soldernerd/LubricatonController_Hardware/CentralLubrication_RevA.brd

## EAGLE design CentralLubrication_RevA.brd (2020-12-08)

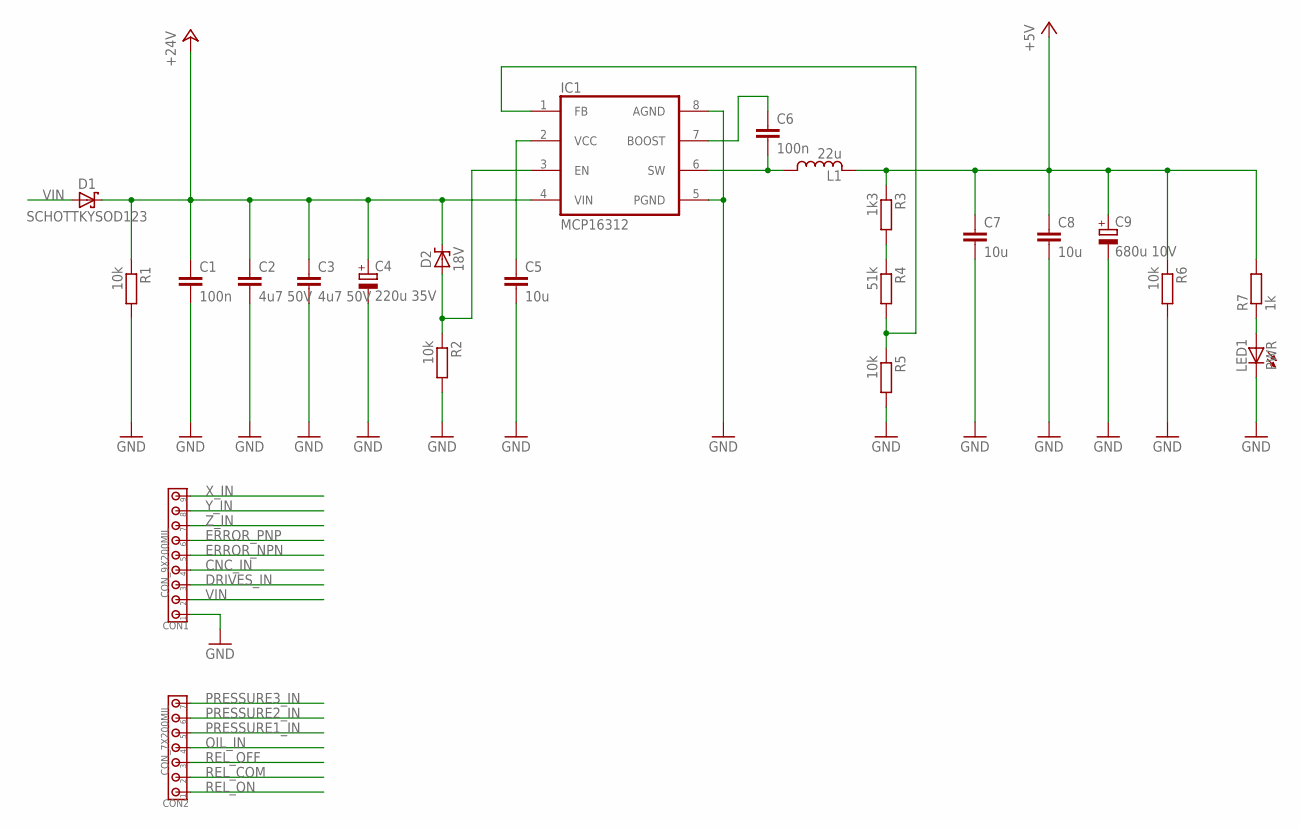
[picture p1: schematic CentralLubrication_RevA.sch, sheet 1]

Parts:
C1, C6: 100n; C0805
C2, C3: 4u7 50V; C1206
C4: 220u 35V; 8MM
C5, C7, C8: 10u; C0805
C9: 680u 10V; 8MM
CON1: CON_9X200MIL; 200MIL_9X
CON2: CON_7X200MIL; 200MIL_7X
D1: SCHOTTKYSOD123; SOD123
D2: 18V; SOD323
IC1: MCP16312; MSOP8
L1: 22u; LPS4018
LED1: PWR; LED0805_NOBOARDER
R1, R2, R5, R6: 10k; R0805
R3: 1k3; R0805
R4: 51k; R0805
R7: 1k; R0805

Connections:
+5V: C7.1, C8.1, C9.+, L1.2, R3.1, R6.1, R7.2; also elsewhere on the board
+24V: C1.1, C2.1, C3.1, C4.+, D1.C, D2.C, IC1.4 (VIN), R1.1; also elsewhere on the board
BOOST: C6.1, IC1.7 (BOOST)
CNC_IN: CON1.4; also elsewhere on the board
DRIVES_IN: CON1.3; also elsewhere on the board
ERROR_NPN: CON1.5; also elsewhere on the board
ERROR_PNP: CON1.6; also elsewhere on the board
GND: C1.2, C2.2, C3.2, C4.-, C5.2, C7.2, C8.2, C9.-, CON1.1, IC1.5 (PGND), IC1.8 (AGND), LED1.C, R1.2, R2.2, R5.2, R6.2; also elsewhere on the board
unnamed: IC1.1 (FB), R4.2, R5.1
unnamed: R3.2, R4.1
unnamed: C5.1, IC1.2 (VCC)
unnamed: D2.A, IC1.3 (EN), R2.1
unnamed: LED1.A, R7.1
OIL_IN: CON2.4; also elsewhere on the board
PRESSURE1_IN: CON2.5; also elsewhere on the board
PRESSURE2_IN: CON2.6; also elsewhere on the board
PRESSURE3_IN: CON2.7; also elsewhere on the board
REL_COM: CON2.2; also elsewhere on the board
REL_OFF: CON2.3; also elsewhere on the board
REL_ON: CON2.1; also elsewhere on the board
SWITCH1: C6.2, IC1.6 (SW), L1.1
VIN: CON1.2, D1.A
X_IN: CON1.9; also elsewhere on the board
Y_IN: CON1.8; also elsewhere on the board
Z_IN: CON1.7; also elsewhere on the board

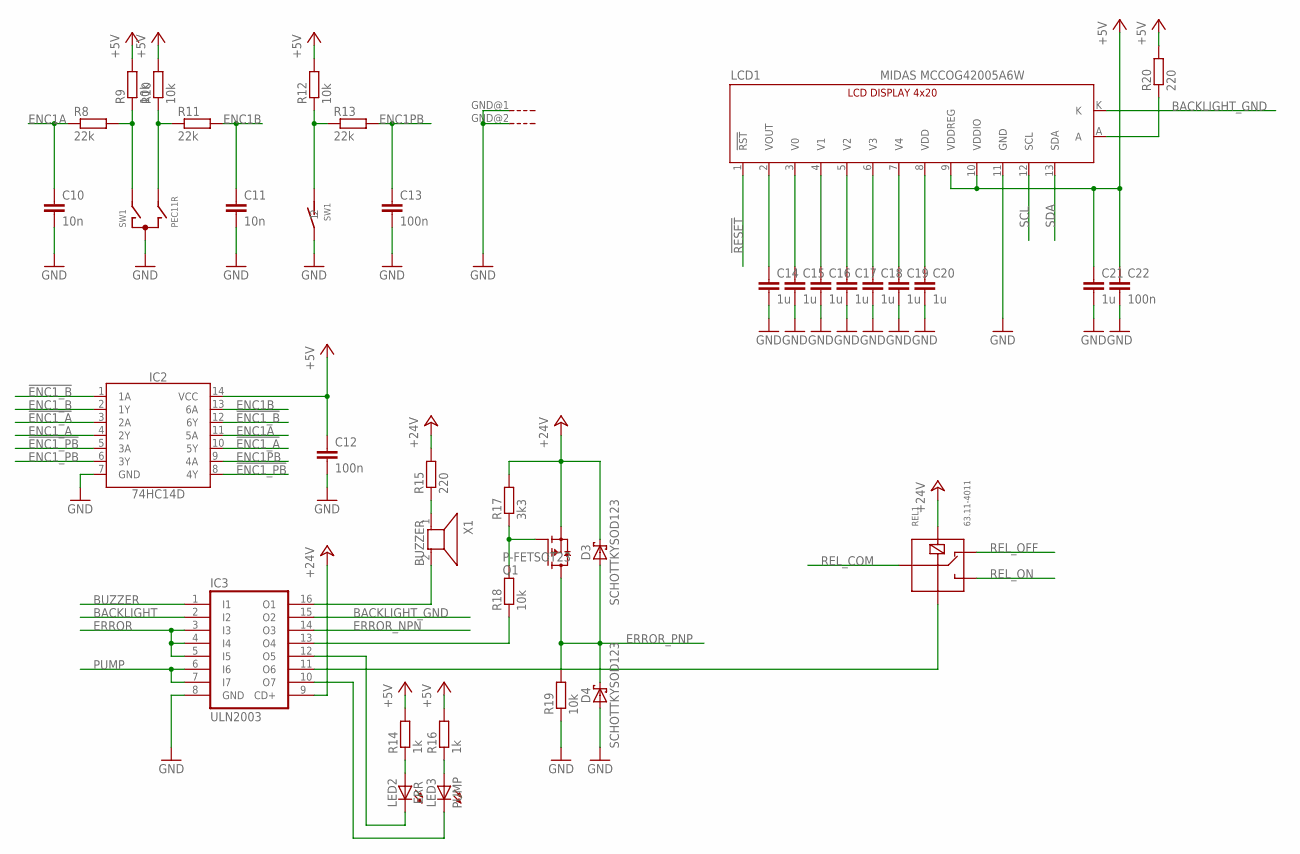
[picture p2: schematic CentralLubrication_RevA.sch, sheet 2]

Parts:
C10, C11: 10n; C0805
C12, C13, C22: 100n; C0805
C14, C15, C16, C17, C18, C19, C20, C21: 1u; C0805
D3, D4: SCHOTTKYSOD123; SOD123
IC2: 74HC14D; SO14
IC3: ULN2003; SO16
LCD1: MIDAS MCCOG42005A6W; LCD_4X20_I2C
LED2: ERR; LED0805_NOBOARDER
LED3: PUMP; LED0805_NOBOARDER
Q1: P-FETSOT23; SOT23
R8, R11, R13: 22k; R0805
R9, R10, R12, R18, R19: 10k; R0805
R14, R16: 1k; R0805
R15, R20: 220; R0805
R17: 3k3; R0805
REL1: 63.11-4011; G5LE
SW1: PEC11R; ENCODER_BOURNS
X1: BUZZER; BUZZER_14MM

Connections:
!ENC1_A!: IC2.3 (2A), IC2.10 (5Y)
!ENC1_B!: IC2.1 (1A), IC2.12 (6Y)
!ENC1_PB!: IC2.5 (3A), IC2.8 (4Y)
!RESET!: LCD1.1 (!RST!); also elsewhere on the board
+5V: C12.1, C21.1, C22.1, IC2.14 (VCC), LCD1.9 (VDDREG), LCD1.10 (VDDIO), R9.2, R10.2, R12.2, R14.2, R16.2, R20.2; also elsewhere on the board
+24V: D3.C, IC3.9 (CD+), Q1.2 (S), R15.2, R17.2, REL1.2; also elsewhere on the board
BACKLIGHT: IC3.2 (I2); also elsewhere on the board
BACKLIGHT_GND: IC3.15 (O2), LCD1.K
BUZZER: IC3.1 (I1); also elsewhere on the board
BUZZER_GND: IC3.16 (O1), X1.2
ENC1A: C10.1, IC2.11 (5A), R8.1
ENC1B: C11.1, IC2.13 (6A), R11.2
ENC1PB: C13.1, IC2.9 (4A), R13.2
ENC1_A: IC2.4 (2Y); also elsewhere on the board
ENC1_B: IC2.2 (1Y); also elsewhere on the board
ENC1_PB: IC2.6 (3Y); also elsewhere on the board
ERROR: IC3.3 (I3), IC3.4 (I4), IC3.5 (I5); also elsewhere on the board
ERROR_NPN: IC3.14 (O3); also elsewhere on the board
ERROR_PNP: D3.A, D4.C, Q1.3 (D), R19.2; also elsewhere on the board
GND: C10.2, C11.2, C12.2, C13.2, C14.2, C15.2, C16.2, C17.2, C18.2, C19.2, C20.2, C21.2, C22.2, D4.A, IC2.7 (GND), IC3.8 (GND), LCD1.11 (GND), R19.1, SW1.2, SW1.C, SW1.GND@1 (G), SW1.GND@2 (G); also elsewhere on the board
unnamed: C20.1, LCD1.8 (VDD)
unnamed: R15.1, X1.1
unnamed: R10.1, R11.1, SW1.B
unnamed: R8.2, R9.1, SW1.A
unnamed: LCD1.A, R20.1
unnamed: IC3.11 (O6), REL1.1
unnamed: Q1.1 (G), R17.1, R18.2
unnamed: R12.1, R13.1, SW1.1
unnamed: IC3.13 (O4), R18.1
unnamed: C14.1, LCD1.2 (VOUT)
unnamed: C15.1, LCD1.3 (V0)
unnamed: C19.1, LCD1.7 (V4)
unnamed: C18.1, LCD1.6 (V3)
unnamed: C17.1, LCD1.5 (V2)
unnamed: C16.1, LCD1.4 (V1)
unnamed: IC3.10 (O7), LED3.C
unnamed: LED2.A, R14.1
unnamed: LED3.A, R16.1
unnamed: IC3.12 (O5), LED2.C
PUMP: IC3.6 (I6), IC3.7 (I7); also elsewhere on the board
REL_COM: REL1.COM; also elsewhere on the board
REL_OFF: REL1.O; also elsewhere on the board
REL_ON: REL1.C; also elsewhere on the board
SCL: LCD1.12 (SCL); also elsewhere on the board
SDA: LCD1.13 (SDA); also elsewhere on the board

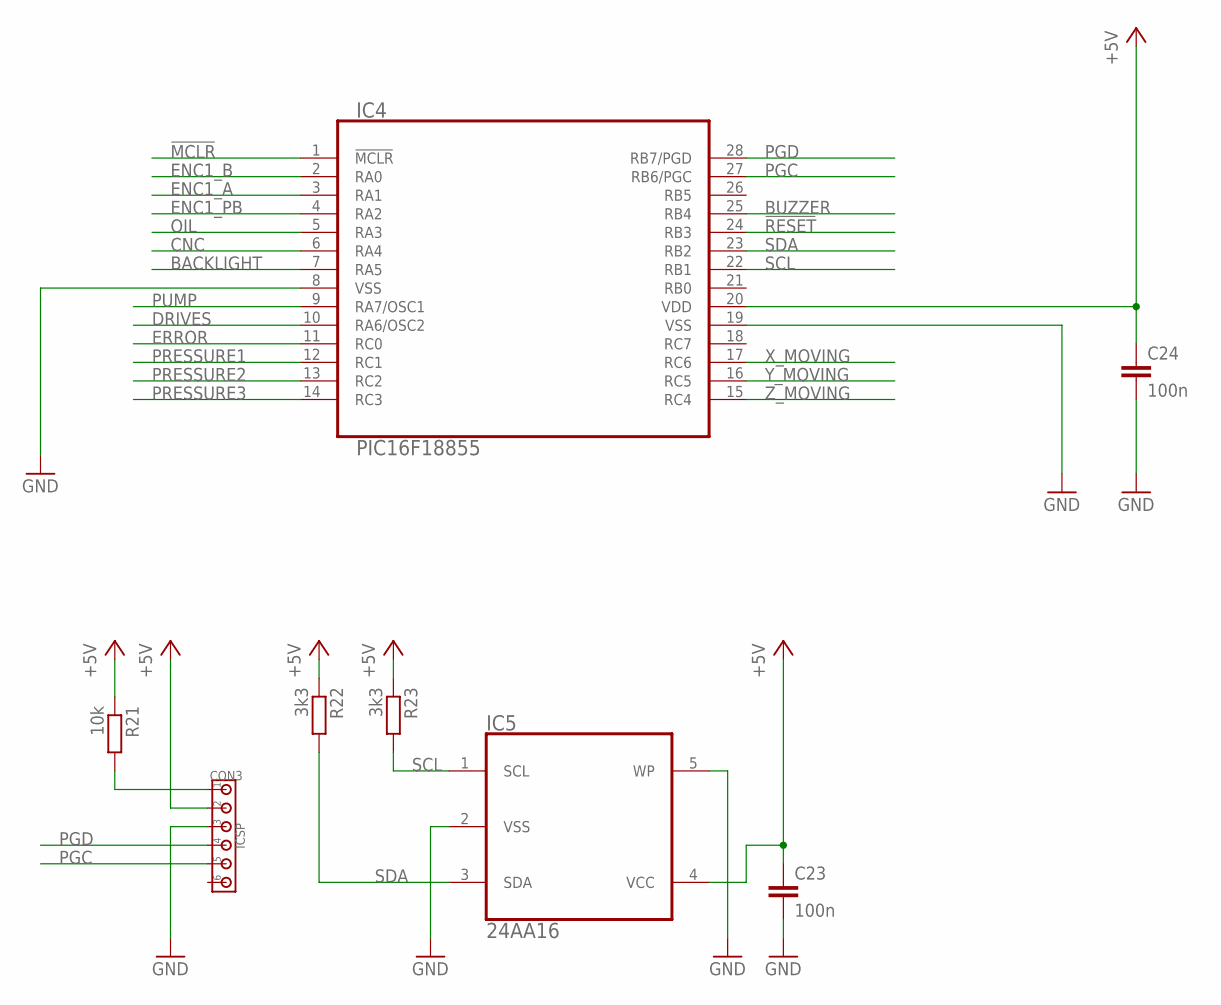
[picture p3: schematic CentralLubrication_RevA.sch, sheet 3]

Parts:
C23, C24: 100n; C0805
CON3: ICSP; 100MIL_6X
IC4: PIC16F18855; SO28W
IC5: 24AA16; SOT-23-5
R21: 10k; R0805
R22, R23: 3k3; R0805

Connections:
!MCLR!: CON3.1, IC4.1 (!MCLR!), R21.2
!RESET!: IC4.24 (RB3); also elsewhere on the board
+5V: C23.1, C24.1, CON3.2, IC4.20 (VDD), IC5.4 (VCC), R21.1, R22.1, R23.1; also elsewhere on the board
BACKLIGHT: IC4.7 (RA5); also elsewhere on the board
BUZZER: IC4.25 (RB4); also elsewhere on the board
CNC: IC4.6 (RA4); also elsewhere on the board
DRIVES: IC4.10 (RA6/OSC2); also elsewhere on the board
ENC1_A: IC4.3 (RA1); also elsewhere on the board
ENC1_B: IC4.2 (RA0); also elsewhere on the board
ENC1_PB: IC4.4 (RA2); also elsewhere on the board
ERROR: IC4.11 (RC0); also elsewhere on the board
GND: C23.2, C24.2, CON3.3, IC4.8 (VSS), IC4.19 (VSS), IC5.2 (VSS), IC5.5 (WP); also elsewhere on the board
OIL: IC4.5 (RA3); also elsewhere on the board
PGC: CON3.5, IC4.27 (RB6/PGC)
PGD: CON3.4, IC4.28 (RB7/PGD)
PRESSURE1: IC4.12 (RC1); also elsewhere on the board
PRESSURE2: IC4.13 (RC2); also elsewhere on the board
PRESSURE3: IC4.14 (RC3); also elsewhere on the board
PUMP: IC4.9 (RA7/OSC1); also elsewhere on the board
SCL: IC4.22 (RB1), IC5.1 (SCL), R23.2; also elsewhere on the board
SDA: IC4.23 (RB2), IC5.3 (SDA), R22.2; also elsewhere on the board
X_MOVING: IC4.17 (RC6); also elsewhere on the board
Y_MOVING: IC4.16 (RC5); also elsewhere on the board
Z_MOVING: IC4.15 (RC4); also elsewhere on the board

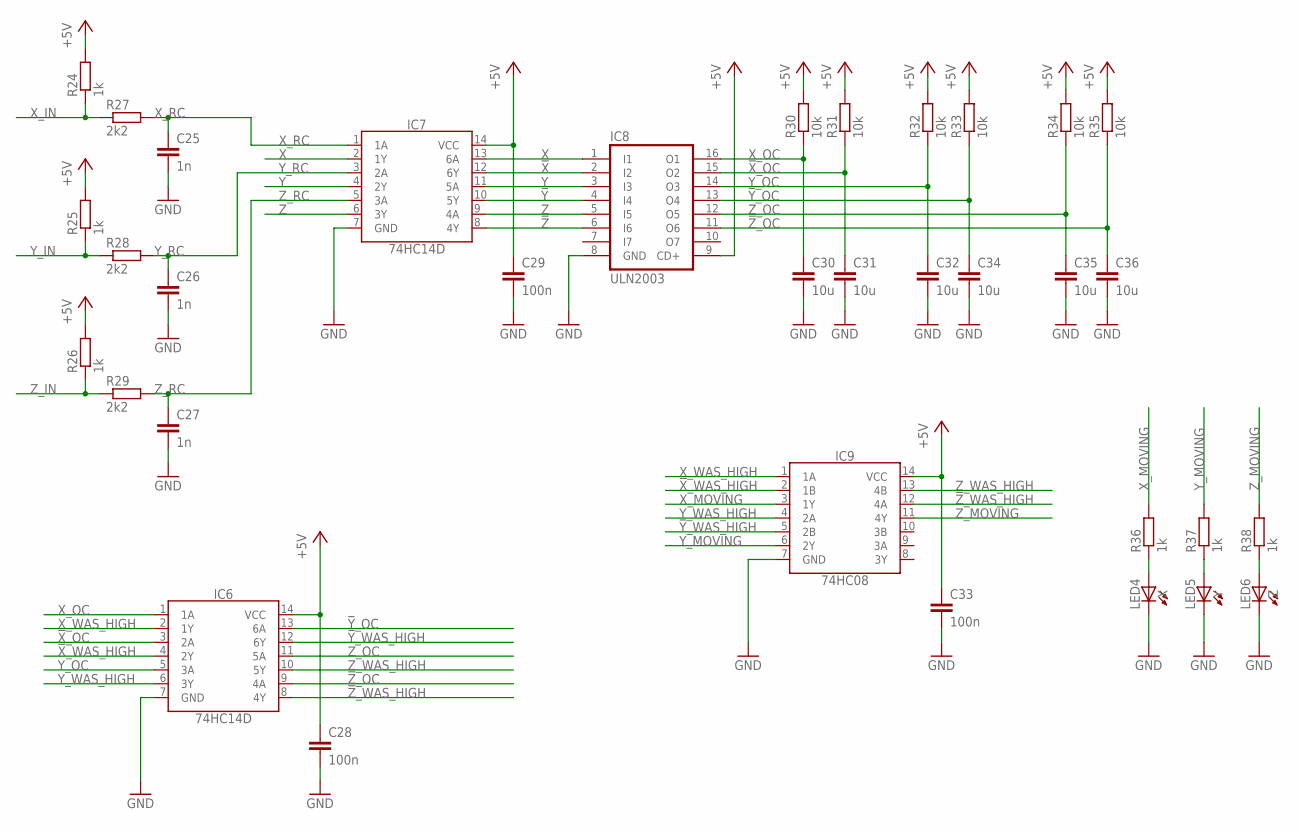
[picture p4: schematic CentralLubrication_RevA.sch, sheet 4]

Parts:
C25, C26, C27: 1n; C0805
C28, C29, C33: 100n; C0805
C30, C31, C32, C34, C35, C36: 10u; C0805
IC6, IC7: 74HC14D; SO14
IC8: ULN2003; SO16
IC9: 74HC08; SO14
LED4: X; LED0805_NOBOARDER
LED5: Y; LED0805_NOBOARDER
LED6: Z; LED0805_NOBOARDER
R24, R25, R26, R36, R37, R38: 1k; R0805
R27, R28, R29: 2k2; R0805
R30, R31, R32, R33, R34, R35: 10k; R0805

Connections:
!X!: IC7.12 (6Y), IC8.2 (I2)
!X!_OC: C31.1, IC6.3 (2A), IC8.15 (O2), R31.1
!X!_WAS_HIGH: IC6.4 (2Y), IC9.2 (1B)
!Y!: IC7.10 (5Y), IC8.4 (I4)
!Y!_OC: C34.1, IC6.13 (6A), IC8.13 (O4), R33.1
!Y!_WAS_HIGH: IC6.12 (6Y), IC9.5 (2B)
!Z!: IC7.8 (4Y), IC8.6 (I6)
!Z!_OC: C36.1, IC6.9 (4A), IC8.11 (O6), R35.1
!Z!_WAS_HIGH: IC6.8 (4Y), IC9.12 (4A)
+5V: C28.1, C29.1, C33.1, IC6.14 (VCC), IC7.14 (VCC), IC8.9 (CD+), IC9.14 (VCC), R24.2, R25.2, R26.2, R30.2, R31.2, R32.2, R33.2, R34.2, R35.2; also elsewhere on the board
GND: C25.2, C26.2, C27.2, C28.2, C29.2, C30.2, C31.2, C32.2, C33.2, C34.2, C35.2, C36.2, IC6.7 (GND), IC7.7 (GND), IC8.8 (GND), IC9.7 (GND), LED4.C, LED5.C, LED6.C; also elsewhere on the board
unnamed: LED4.A, R36.1
unnamed: LED5.A, R37.1
unnamed: LED6.A, R38.1
X: IC7.2 (1Y), IC7.13 (6A), IC8.1 (I1)
X_IN: R24.1, R27.1; also elsewhere on the board
X_MOVING: IC9.3 (1Y), R36.2; also elsewhere on the board
X_OC: C30.1, IC6.1 (1A), IC8.16 (O1), R30.1
X_RC: C25.1, IC7.1 (1A), R27.2
X_WAS_HIGH: IC6.2 (1Y), IC9.1 (1A)
Y: IC7.4 (2Y), IC7.11 (5A), IC8.3 (I3)
Y_IN: R25.1, R28.1; also elsewhere on the board
Y_MOVING: IC9.6 (2Y), R37.2; also elsewhere on the board
Y_OC: C32.1, IC6.5 (3A), IC8.14 (O3), R32.1
Y_RC: C26.1, IC7.3 (2A), R28.2
Y_WAS_HIGH: IC6.6 (3Y), IC9.4 (2A)
Z: IC7.6 (3Y), IC7.9 (4A), IC8.5 (I5)
Z_IN: R26.1, R29.1; also elsewhere on the board
Z_MOVING: IC9.11 (4Y), R38.2; also elsewhere on the board
Z_OC: C35.1, IC6.11 (5A), IC8.12 (O5), R34.1
Z_RC: C27.1, IC7.5 (3A), R29.2
Z_WAS_HIGH: IC6.10 (5Y), IC9.13 (4B)

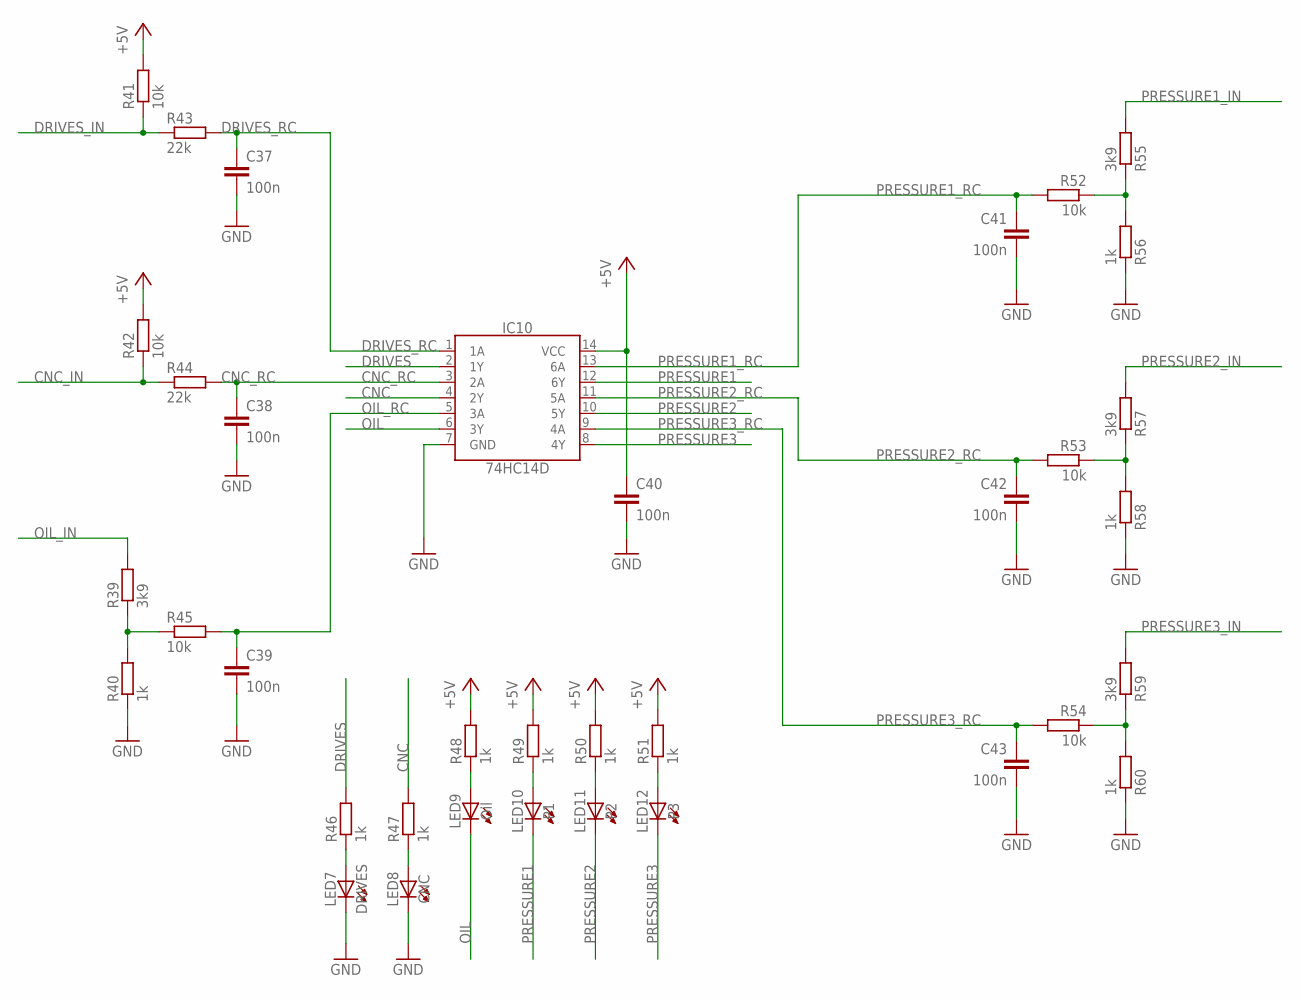
[picture p5: schematic CentralLubrication_RevA.sch, sheet 5]

Parts:
C37, C38, C39, C40, C41, C42, C43: 100n; C0805
IC10: 74HC14D; SO14
LED7: DRIVES; LED0805_NOBOARDER
LED8: CNC; LED0805_NOBOARDER
LED9: Oil; LED0805_NOBOARDER
LED10: P1; LED0805_NOBOARDER
LED11: P2; LED0805_NOBOARDER
LED12: P3; LED0805_NOBOARDER
R39, R55, R57, R59: 3k9; R0805
R40, R46, R47, R48, R49, R50, R51, R56, R58, R60: 1k; R0805
R41, R42, R45, R52, R53, R54: 10k; R0805
R43, R44: 22k; R0805

Connections:
+5V: C40.1, IC10.14 (VCC), R41.2, R42.2, R48.2, R49.2, R50.2, R51.2; also elsewhere on the board
CNC: IC10.4 (2Y), R47.2; also elsewhere on the board
CNC_IN: R42.1, R44.1; also elsewhere on the board
CNC_RC: C38.1, IC10.3 (2A), R44.2
DRIVES: IC10.2 (1Y), R46.2; also elsewhere on the board
DRIVES_IN: R41.1, R43.1; also elsewhere on the board
DRIVES_RC: C37.1, IC10.1 (1A), R43.2
GND: C37.2, C38.2, C39.2, C40.2, C41.2, C42.2, C43.2, IC10.7 (GND), LED7.C, LED8.C, R40.1, R56.1, R58.1, R60.1; also elsewhere on the board
unnamed: R39.1, R40.2, R45.1
unnamed: R52.1, R55.1, R56.2
unnamed: R53.1, R57.1, R58.2
unnamed: R54.1, R59.1, R60.2
unnamed: LED7.A, R46.1
unnamed: LED8.A, R47.1
unnamed: LED9.A, R48.1
unnamed: LED10.A, R49.1
unnamed: LED11.A, R50.1
unnamed: LED12.A, R51.1
OIL: IC10.6 (3Y), LED9.C; also elsewhere on the board
OIL_IN: R39.2; also elsewhere on the board
OIL_RC: C39.1, IC10.5 (3A), R45.2
PRESSURE1: IC10.12 (6Y), LED10.C; also elsewhere on the board
PRESSURE1_IN: R55.2; also elsewhere on the board
PRESSURE1_RC: C41.1, IC10.13 (6A), R52.2
PRESSURE2: IC10.10 (5Y), LED11.C; also elsewhere on the board
PRESSURE2_IN: R57.2; also elsewhere on the board
PRESSURE2_RC: C42.1, IC10.11 (5A), R53.2
PRESSURE3: IC10.8 (4Y), LED12.C; also elsewhere on the board
PRESSURE3_IN: R59.2; also elsewhere on the board
PRESSURE3_RC: C43.1, IC10.9 (4A), R54.2

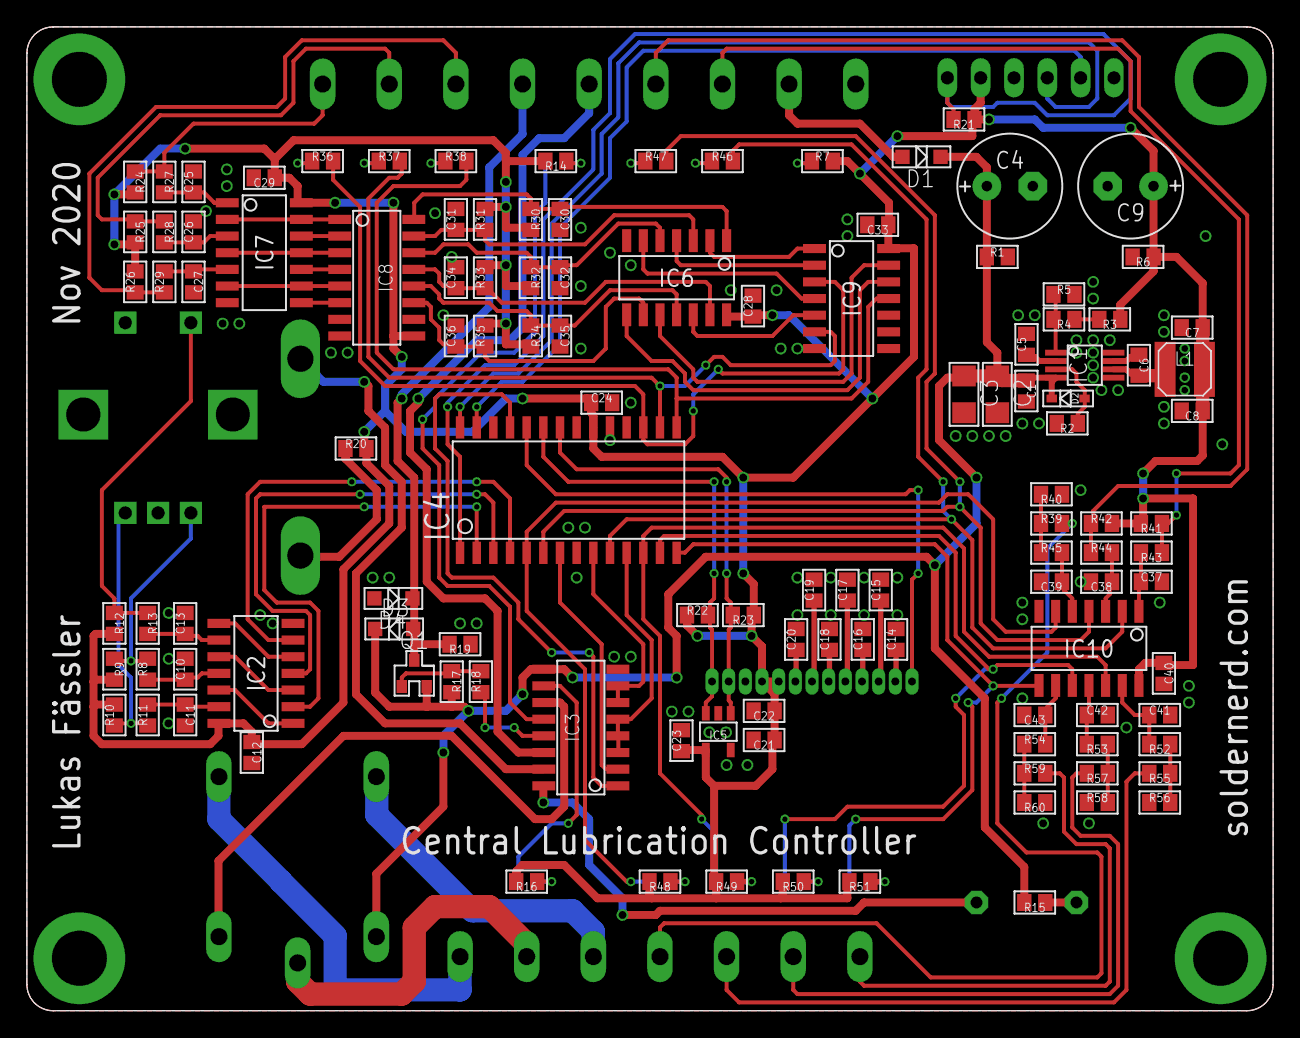
[picture p6: board CentralLubrication_RevA.brd from above]

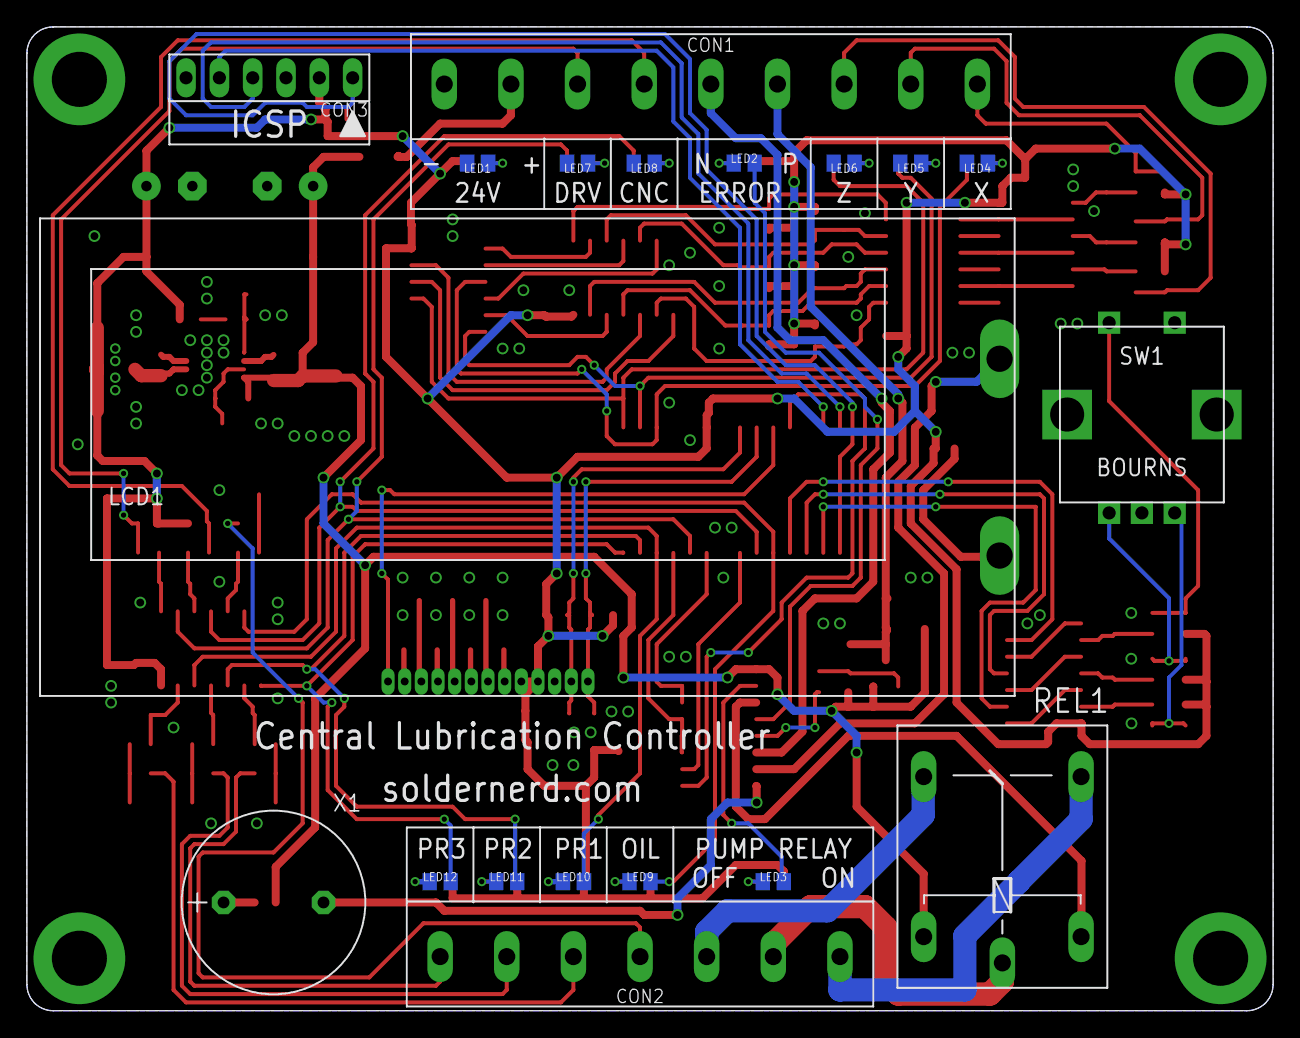
[picture p7: board CentralLubrication_RevA.brd from below]

Board: 2 copper layers, 95.0 x 75.0 mm, 138 parts (19 on the bottom side), 114 nets.
